RaceFPV/StarForgeOS/board/Tracer 1.4 case.stl

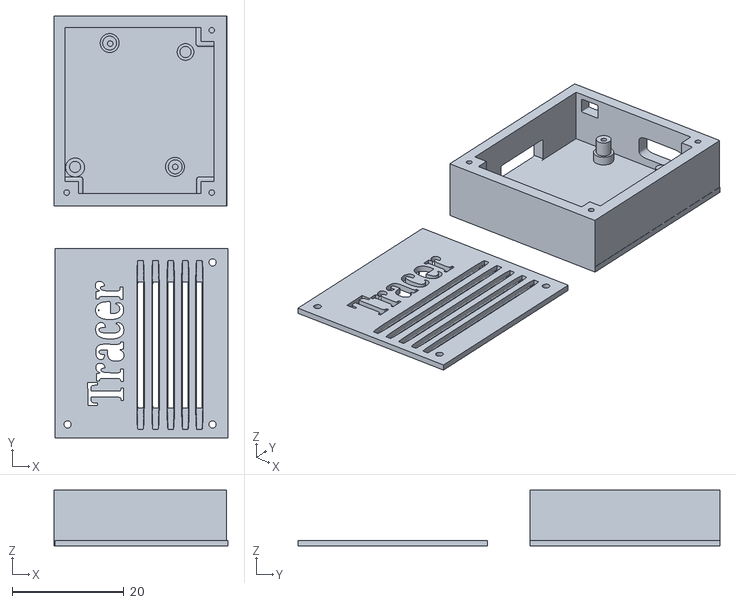
[picture p2: CAD file, 2025-10-19, last stored version]
board/Tracer 1.4 case.stl
31.2 x 75.6 x 10.0
