RaceFPV/StarForgeOS/test/FIXED.md

# Quick Fix Applied! ✅

## What Was Wrong

The test directory structure wasn't quite right for PlatformIO. The error you saw was:
```
TestDirNotExistsError: A test folder '/home/racefpv/git/StarForgeOS/test/test' does not exist.
```

## What I Fixed

### 1. Moved Test Environments to Main `platformio.ini`
- ✅ Added 7 test environments to `StarForgeOS/platformio.ini`
- ✅ Removed duplicate `test/platformio.ini`
- Each board now has a `test-*` environment (e.g., `test-esp32-c3`)

### 2. Updated Test Runner Scripts
- ✅ Changed `run_tests.sh` to run from `StarForgeOS/` directory (not `test/`)
- ✅ Changed `run_tests.bat` similarly for Windows
- Scripts now properly navigate to project root

### 3. Updated Documentation
- ✅ Updated QUICKSTART.md with correct paths
- ✅ Updated INDEX.md with correct commands
- All examples now show running from `StarForgeOS/` directory

## How to Run Tests Now

### From Project Root (Correct Way)

```bash
# Navigate to StarForgeOS directory
cd StarForgeOS

# Run the test script
./test/run_tests.sh build-only
```

### Or Use PlatformIO Directly

```bash
cd StarForgeOS

# Test specific board (build only)
pio test -e test-esp32-c3 --without-uploading --without-testing

# Test all boards
pio test --without-uploading --without-testing

# Test with hardware
pio test -e test-esp32-c3
```

## Directory Structure

```
StarForgeOS/
├── platformio.ini          ← Main config (includes test environments)
├── src/
│   ├── main.cpp
│   ├── config.h
│   └── ...
└── test/                   ← Test directory
    ├── run_tests.sh        ← Run from parent dir
    ├── run_tests.bat       ← Run from parent dir
    ├── test_hardware/
    │   └── test_pin_config.cpp
    ├── test_timing/
    │   └── test_timing_core.cpp
    ├── test_wifi/
    │   └── test_wifi_standalone.cpp
    ├── test_lcd/
    │   └── test_lcd_touch.cpp
    └── docs/
        ├── README.md
        ├── QUICKSTART.md
        └── ...
```

## Try It Now!

```bash
cd StarForgeOS
./test/run_tests.sh build-only
```

This should now work! The test will:
1. Find the test environments in `platformio.ini`
2. Look for test files in `test/test_*/` directories
3. Build all 7 board configurations
4. Report results

## Test Environments Available

Run `pio test --list-environments` to see all test environments:

- `test-esp32-c3`
- `test-esp32-c6`
- `test-esp32`
- `test-esp32-s2`
- `test-esp32-s3`
- `test-esp32-s3-touch`
- `test-jc2432w328c`

## If You Still Get Errors

### Error: "Command not found: ./test/run_tests.sh"
**Solution:** You're not in the StarForgeOS directory
```bash
cd StarForgeOS  # Make sure you're here
pwd             # Should show: .../git/StarForgeOS
./test/run_tests.sh build-only
```

### Error: "Permission denied"
**Solution:** Make script executable (Linux/Mac only)
```bash
chmod +x test/run_tests.sh
```

### Error: Test files not found
**Solution:** Run from StarForgeOS root, not test subdirectory
```bash
cd StarForgeOS  # Not StarForgeOS/test
pio test -e test-esp32-c3 --without-uploading --without-testing
```

## Summary

✅ **Fixed:** Test environment configuration  
✅ **Fixed:** Script paths  
✅ **Fixed:** Documentation  

**Now try:** `cd StarForgeOS && ./test/run_tests.sh build-only`

The tests should work perfectly now! 🎉
