RaceFPV/StarForgeOS/sandbox/lcd_test/src/TFT_eSPI User_Setup.h

#define ST7789_DRIVER 
#define TFT_RGB_ORDER TFT_BGR
#define TFT_WIDTH  240
#define TFT_HEIGHT 320
#define TFT_INVERSION_OFF
#define ESP32_DMA
#define TFT_MOSI 13
#define TFT_SCLK 14
#define TFT_CS   15
#define TFT_DC   2
#define TFT_RST  -1
#define TFT_BL   27
#define TOUCH_CS 33
