RaceFPV/StarForgeOS/(commit log)

2025-10-11 add software into main repo
    [Tracer-1.1.epro, Tracer-1.3.epro]
2025-10-11 rebrand to tracer
2025-10-16 fix the platformio library used so wifi is better
    [config.h, main.cpp, standalone_mode.cpp, standalone_mode.h, timing_core.cpp, timing_core.h]
2025-10-17 fix a serial interface bug with rotorhazard mode
    [config.h, main.cpp, node_mode.cpp, timing_core.cpp]
2025-10-19 add tracer case stl, update readme
    [Tracer 1.4 case.stl]
2025-10-20 try and fix some rssi freq change issues
    [config.h, node_mode.cpp, timing_core.cpp]
2025-10-21 add in tracer-diy board and rssi testing changes
    [Tracer-DIY.epro]
2025-10-21 remove cdc flag on original esp32 board
2025-10-23 update board design to 1.6
    [Tracer-1.1.epro, Tracer-1.3.epro]
2025-10-25 use DMA for the timing core loop
2025-10-25 add a graph to web timer
2025-10-26 fix a bug when building for s3
    [timing_core.cpp]
2025-10-28 fix for esp32 wroom and dma/rssi signal
    [config.h, timing_core.cpp]
2025-10-29 potential working concept for BOARD_JC2432W328C
    [partitions_custom.csv]
2025-11-01 implement several fixes for node mode on touch version
    [partitions_custom.csv]
2025-11-04 add a fix for rotorhazard marshalling, save rssi preference in spiffs
    [lcd_ui.cpp, lcd_ui.h, node_mode.cpp, standalone_mode.cpp, standalone_mode.h, timing_core.cpp, timing_core.h]
2025-11-06 add more board types support, remove a bunch of extra test functions, fix a bug with hardcoded rssi pin
    [config.h, main.js, standalone_mode.cpp, standalone_mode.h, timing_core.cpp, timing_core.h]
2025-11-08 support the waveshare 2.0 touchscreen board, tons of touchscreen improvements
2025-11-14 adjust touchscreen battery detection, make the flash tool smarter
2025-12-26 fix a memory buffer issue with s3 based boards and race history, dont allow multiple race starts
    [config.h, timing_core.cpp, timing_core.h, wifi_manager.cpp]
2026-01-01 tenative fix for esp32-wroom spiffs cache corruption issue
    [config.h, main.cpp, timing_core.cpp, web_server.cpp, web_server.h]
2026-01-06 add potential support for a 2mb flash option
    [partitions_2mb.csv]
2026-01-07 fix a bug with gpio use on nuclearcounter boards
    [config.h]
2026-01-07 rewrite of webserver code, pause to serve large files, fixes for nuclearcounter
    [config.h, main.cpp, standalone_mode.cpp, timing_core.cpp, timing_core.h, web_server.cpp]
2026-01-08 fix a crash with c6 boards on the new async webserver
    [web_server.cpp]
2026-01-08 fixes for touchscreen versions
    [config.h, lcd_ui.cpp, lcd_ui.h, timing_core.h]
2026-01-15 lots of work and cleanup for the novablade board (waveshare touch)
2026-03-24 fix a bug where freq was not setting correctly on web interface
    [web_server.cpp]
2026-04-11 adjust IF to match our saw filter
2026-07-08 continue sandbox max work, fix some bugs, unclamp adc for sweep tests, etc
    [main.cpp]
